djsouthall/hpol-prototype/design/Tri-Slot/Model 8 in/trislot_8in_assembled_feed_full_11-17-2020.stp

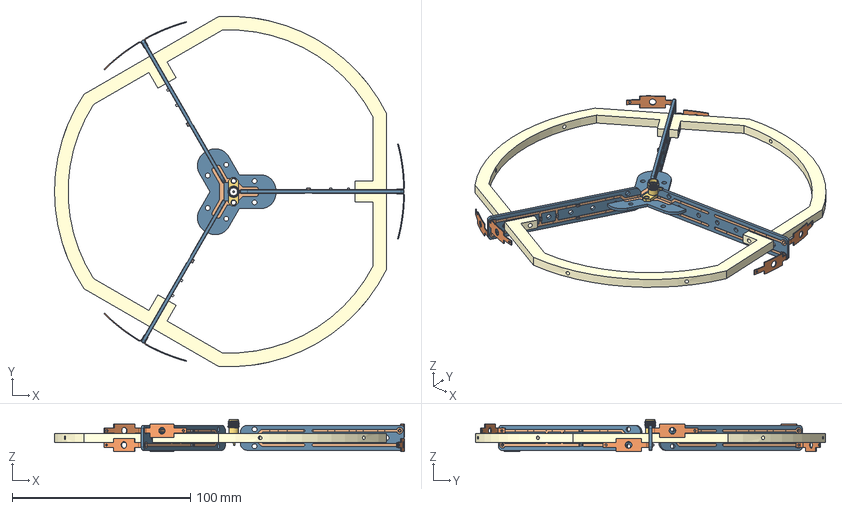
[picture p5: CAD file, 2020-11-19]
design/Tri-Slot/Model 8 in/trislot_8in_assembled_feed_full_11-17-2020.stp
196.1 x 196.2 x 18.1 mm
digikey-mockup-A114140-ND x 6
coppers_drilled#F.Cu x 3
board_solid#F.Cu x 3
insert_8in x 3
board_solid#F.Cu_1
coppers_drilled#F.Cu_1
