djsouthall/hpol-prototype/design/Feed Design/quad-slot-hub_revA/quad-slot-hub_revA/quad-slot-hub-traces.step

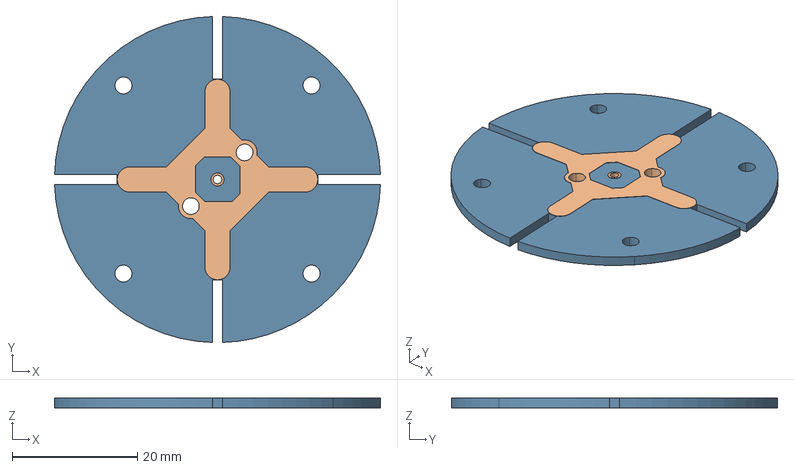
[picture p7: CAD file, 2020-11-04]
design/Feed Design/quad-slot-hub_revA/quad-slot-hub_revA/quad-slot-hub-traces.step
52.0 x 52.0 x 1.60 mm
