djsouthall/hpol-prototype/design/Feed Design/tri-slot-feedlines_revC/tri-slot-feedlines.step

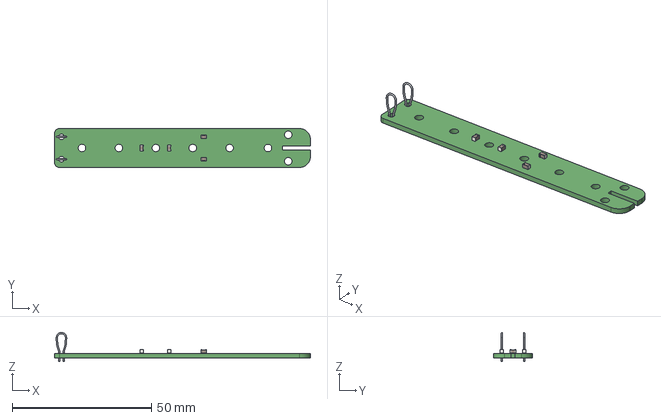
[picture p8: CAD file, 2020-10-09]
design/Feed Design/tri-slot-feedlines_revC/tri-slot-feedlines.step
91.8 x 14.0 x 10.4 mm
