djsouthall/hpol-prototype/design/Feed Design/tri-slot-hub/tri-slot-hub/tri-slot-hub_with_traces_no_sma.step

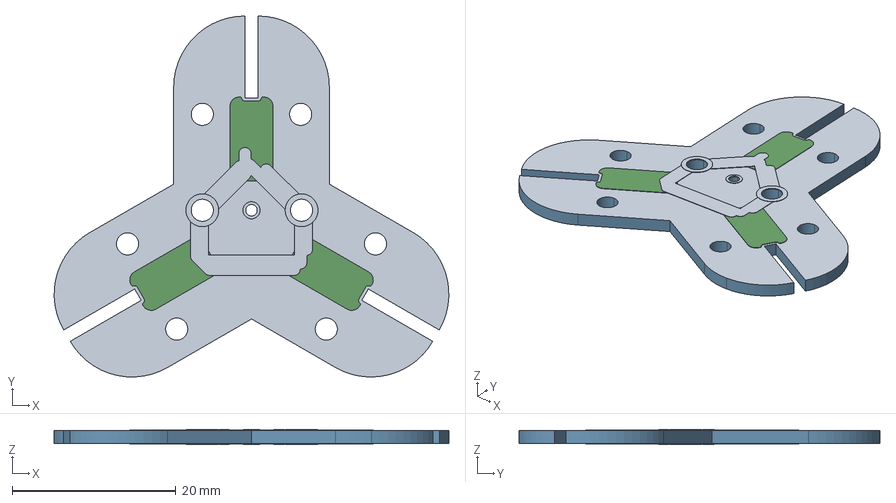
[picture p9: CAD file, 2020-10-19]
design/Feed Design/tri-slot-hub/tri-slot-hub/tri-slot-hub_with_traces_no_sma.step
48.2 x 44.0 x 1.80 mm
