djsouthall/hpol-prototype/design/Feed Design/tri-slot-hub/tri-slot-hub_with_copper.stp

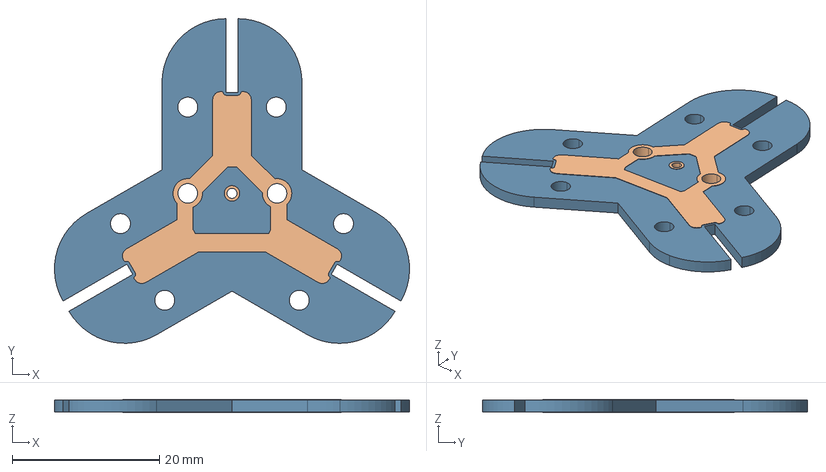
[picture p10: CAD file, 2020-11-19]
design/Feed Design/tri-slot-hub/tri-slot-hub_with_copper.stp
48.2 x 44.0 x 1.70 mm
