djsouthall/hpol-prototype/design/Quad-Slot/Model 8 in/source/hub/raw step/tri-slot-hub.step

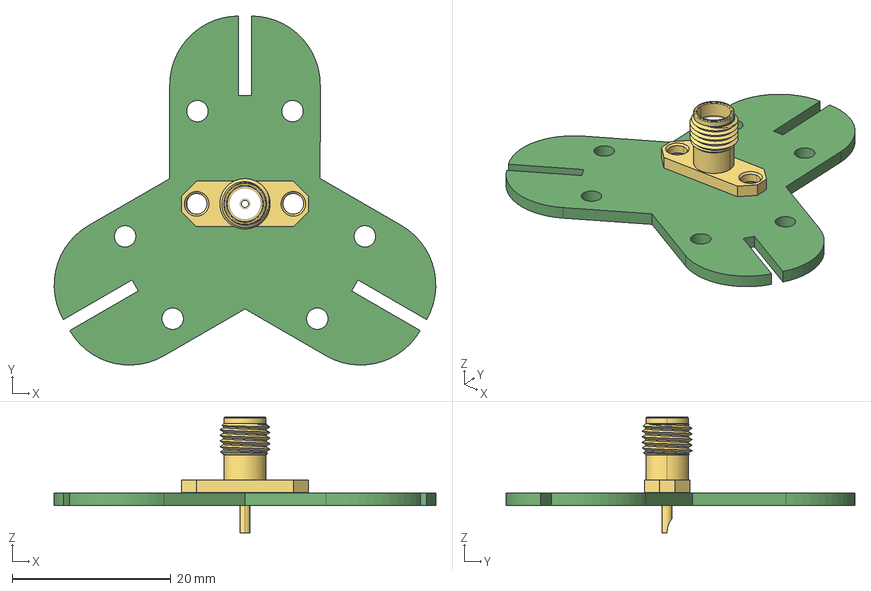
[picture p11: CAD file, 2020-10-09]
design/Quad-Slot/Model 8 in/source/hub/raw step/tri-slot-hub.step
48.2 x 44.0 x 14.6 mm
