djsouthall/hpol-prototype/design/Quad-Slot/Model 8 in/source/my can/quadslot_8in_can_closed_v1.stp

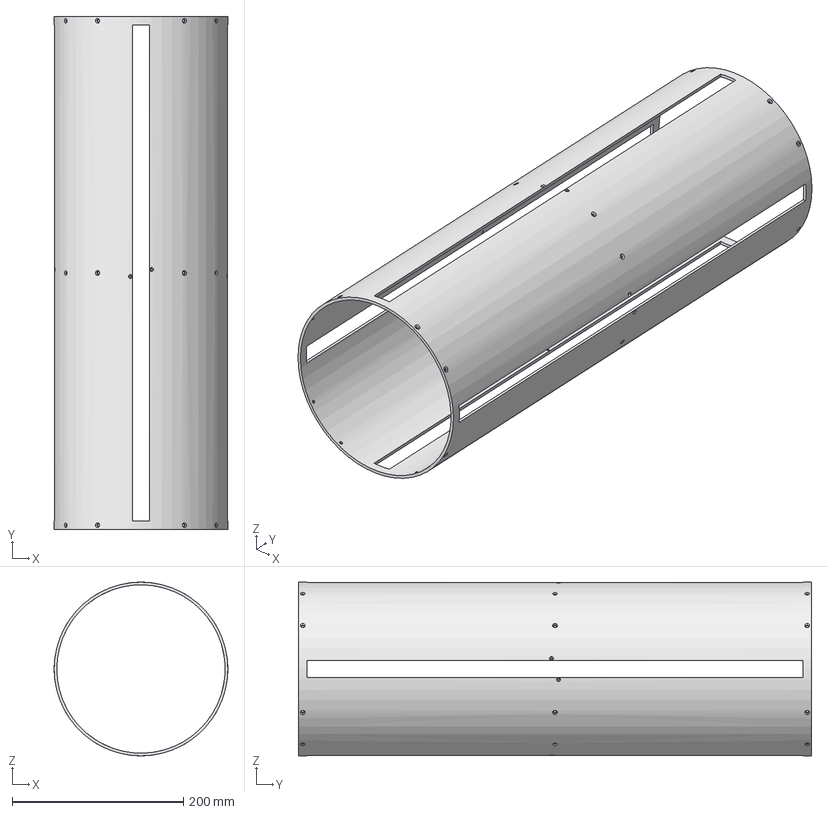
[picture p13: CAD file, 2020-11-13]
design/Quad-Slot/Model 8 in/source/my can/quadslot_8in_can_closed_v1.stp
203.2 x 600.0 x 203.2 mm
