djsouthall/hpol-prototype/design/Quad-Slot/Model 8 in/source/raw step files/aluminum-hpol-can.STEP

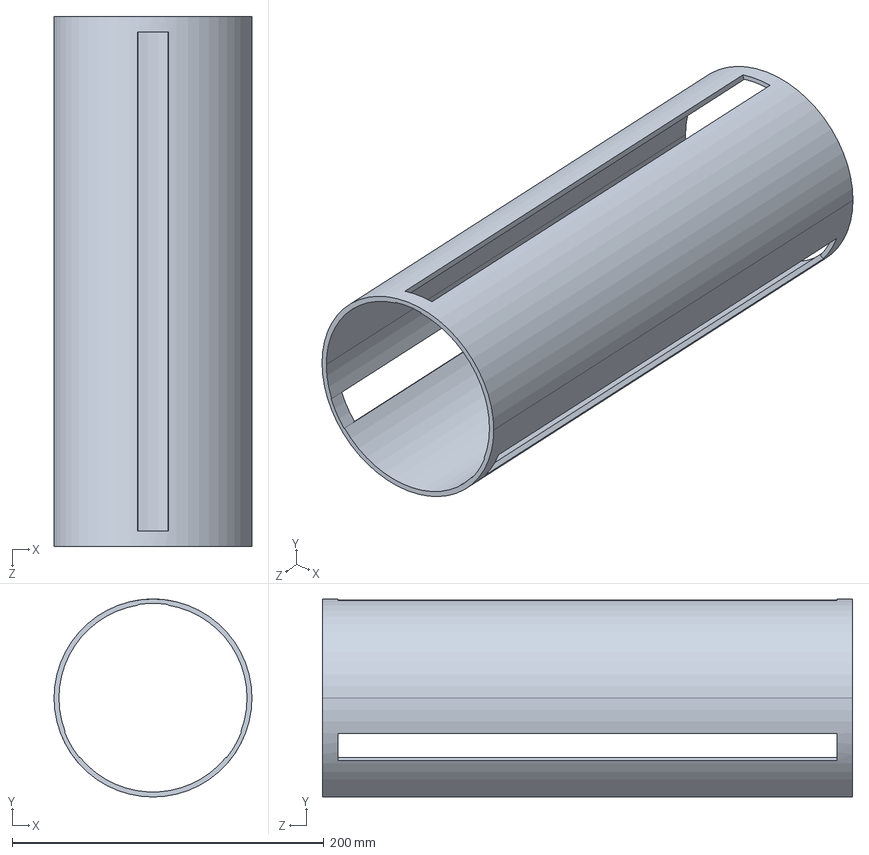
[picture p14: CAD file, 2020-10-09]
design/Quad-Slot/Model 8 in/source/raw step files/aluminum-hpol-can.STEP
127.0 x 127.0 x 340.0 mm
