djsouthall/hpol-prototype/design/Tri-Slot/Model 5 in/source/bryan_insert/raw step/HPol Nylon with Cuts and Reduced Thickness.STEP

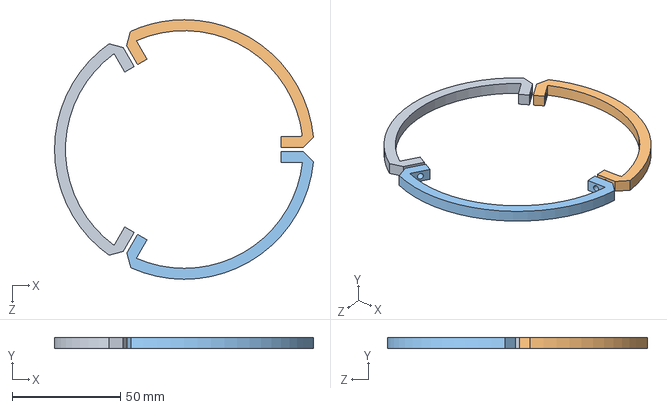
[picture p15: CAD file, 2020-10-09]
design/Tri-Slot/Model 5 in/source/bryan_insert/raw step/HPol Nylon with Cuts and Reduced Thickness.STEP
119.9 x 5.08 x 120.1 mm
