djsouthall/hpol-prototype/design/Tri-Slot/Model 5 in/source/faceplate/raw_step/faceplate.STEP

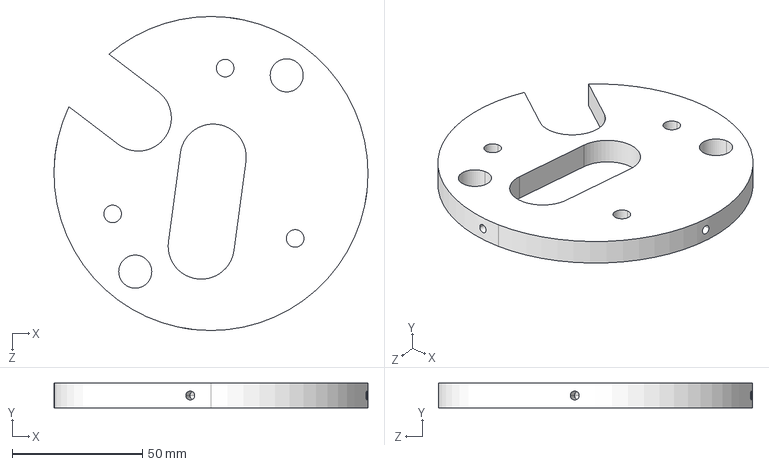
[picture p16: CAD file, 2020-10-09]
design/Tri-Slot/Model 5 in/source/faceplate/raw_step/faceplate.STEP
120.6 x 9.53 x 120.6 mm
