djsouthall/hpol-prototype/design/Tri-Slot/Model 8 in/source/feed_8in_with_copper.step

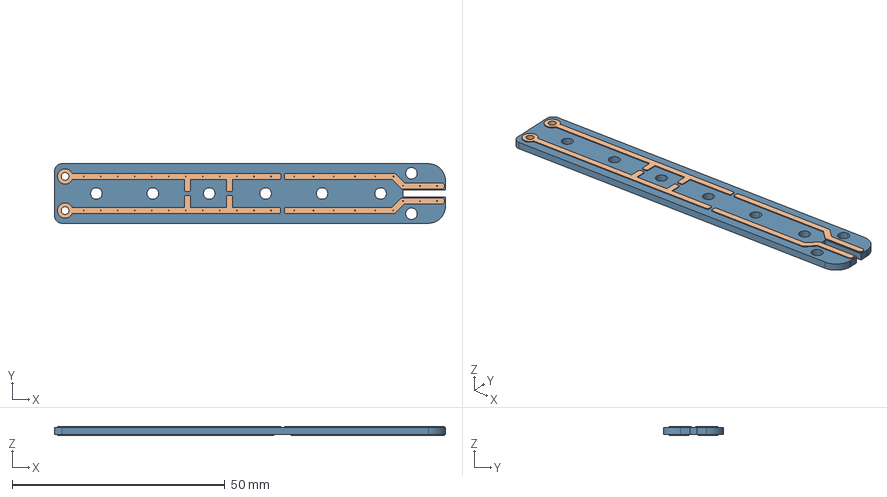
[picture p17: CAD file, 2020-10-09]
design/Tri-Slot/Model 8 in/source/feed_8in_with_copper.step
91.8 x 14.0 x 2.00 mm
