djsouthall/hpol-prototype/design/Tri-Slot/Model 8 in/source/my can/can_open.stp

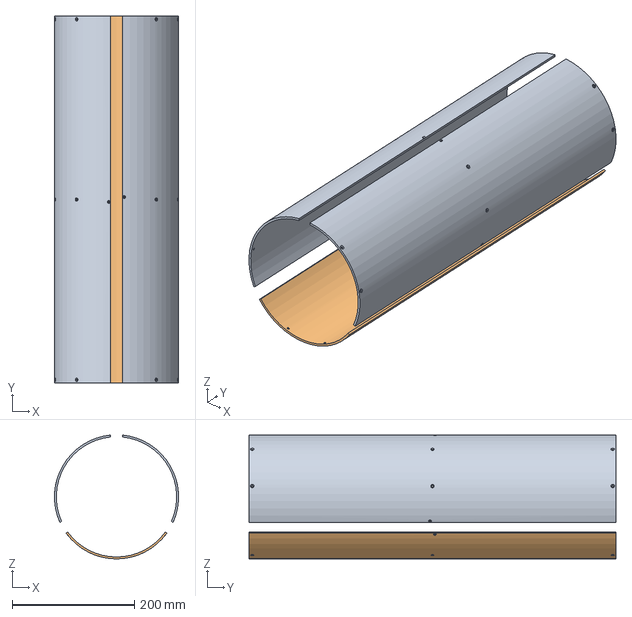
[picture p18: CAD file, 2020-11-03]
design/Tri-Slot/Model 8 in/source/my can/can_open.stp
203.0 x 600.0 x 202.7 mm
