djsouthall/hpol-prototype/design/Tri-Slot/Model 8 in/source/raw step files/tri-slot-feedlines.step

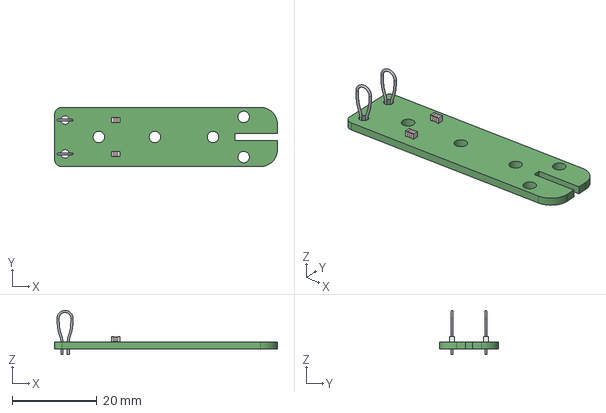
[picture p19: CAD file, 2020-10-09]
design/Tri-Slot/Model 8 in/source/raw step files/tri-slot-feedlines.step
52.8 x 14.0 x 10.4 mm
