djsouthall/hpol-prototype/design/Vpol Parts/End Caps/hub_support.STEP

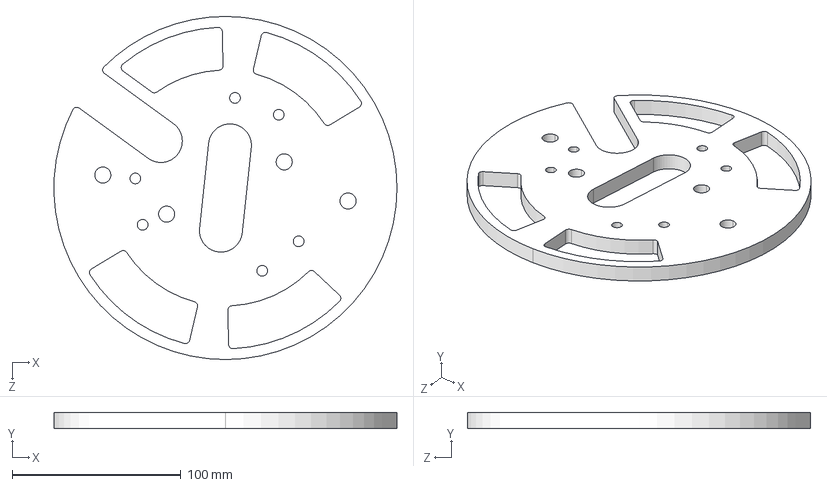
[picture p20: CAD file, 2020-11-19]
design/Vpol Parts/End Caps/hub_support.STEP
203.1 x 9.53 x 203.2 mm
