djsouthall/hpol-prototype/design/Tri-Slot/Model 8 in/source/my can/can_#2_hardware.stp

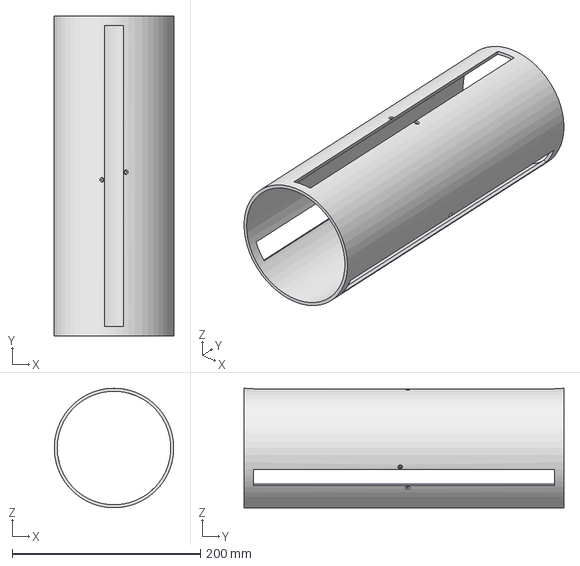
[picture p22: CAD file, 2020-10-09]
design/Tri-Slot/Model 8 in/source/my can/can_#2_hardware.stp
127.0 x 340.0 x 127.0 mm
