djsouthall/hpol-prototype/design/Quad-Slot/Model 8 in/source/front_end_box.STEP

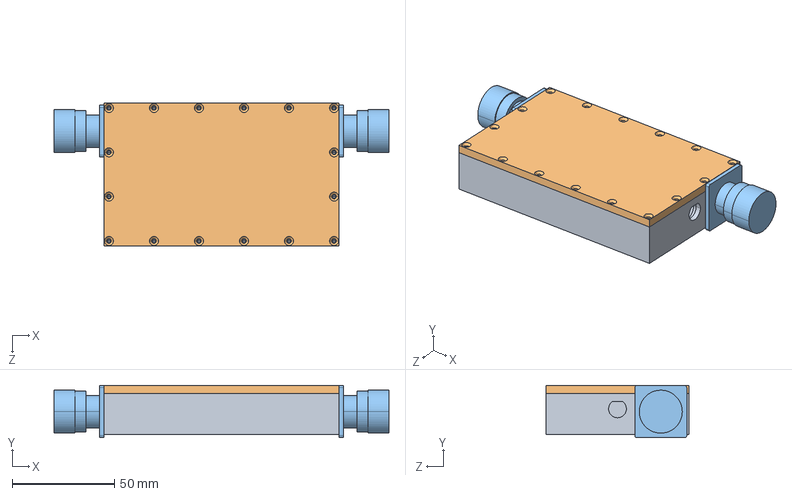
[picture p24: CAD file, 2020-11-19]
design/Quad-Slot/Model 8 in/source/front_end_box.STEP
163.6 x 25.6 x 70.0 mm
inice_bottom
inice_top
fake_sma_with_cable x 2
