djsouthall/hpol-prototype/design/Quad-Slot/Model 8 in/source/quadslot_8in_insert_top_face_v1.dxf

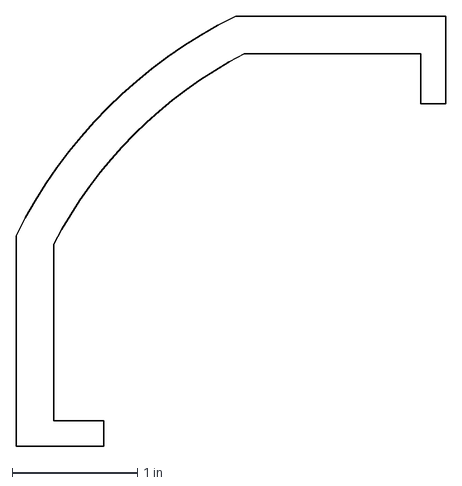
[picture p25: CAD file, 2020-11-13]
design/Quad-Slot/Model 8 in/source/quadslot_8in_insert_top_face_v1.dxf
3.43 x 3.43 in
