djsouthall/hpol-prototype/design/Quad-Slot/Model 8 in/source/2933-6001.STEP

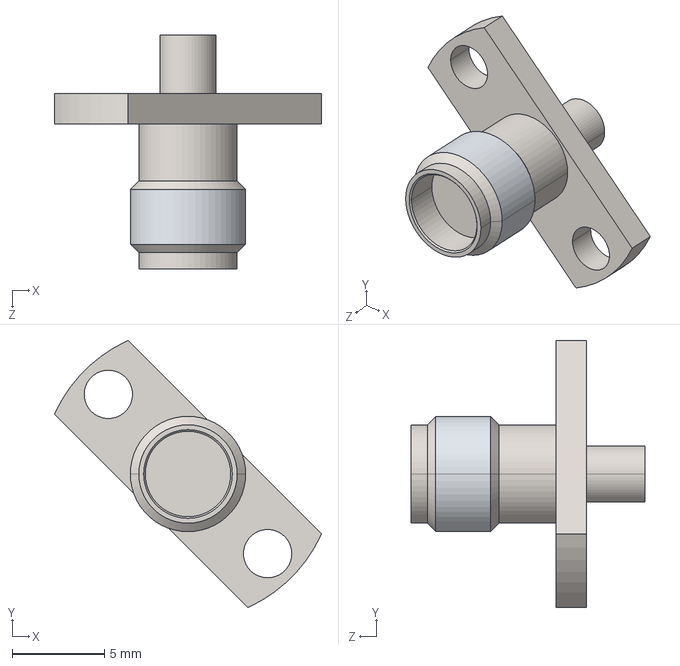
[picture p26: CAD file, 2020-10-19]
design/Quad-Slot/Model 8 in/source/2933-6001.STEP
14.5 x 14.5 x 12.7 mm
