djsouthall/hpol-prototype/(list of files, cad)

Other CAD files:
design/Tri-Slot/Model 8 in/trislot_8in_assembled_feed_no-sma-no-passives_11-17-2020.stp
design/Quad-Slot/Model 8 in/source/my can/can_closed.stp
design/Quad-Slot/Model 8 in/source/quadslot__8in_endcap_drawing_v1.dwg
design/Tri-Slot/Model 8 in/source/my can/can_closed.stp
design/Quad-Slot/Model 8 in/source/my can/can_open.stp
design/Quad-Slot/Model 8 in/source/quadslot__8in_insert_drawing_v2_with_context.dwg
design/Tri-Slot/Model 8 in/source/my can/can_8in_2insert_holes.stp
design/Quad-Slot/Model 8 in/source/my can/can_8in_2insert_holes.stp
design/Quad-Slot/Model 8 in/source/quadslot__8in_insert_drawing_v2.dwg
design/Tri-Slot/Model 8 in/source/my can/can_#1_hardware.stp
design/Quad-Slot/Model 8 in/source/my can/can_all_holes.stp
design/Tri-Slot/Model 8 in/source/my can/can_all_holes.stp
design/Quad-Slot/Model 8 in/source/my can/can_#1_hardware.stp
design/Quad-Slot/Model 8 in/source/quadslot_8in_can_drawing_v1.dwg
design/Feed Design/tri-slot-feedlines_revC/SOLID_1.ipt
design/Feed Design/tri-slot-feedlines_revC/TestPoint_Loop_D3.80mm_Drill2.0mm.iam
design/Model 8 in/source/OldVersions/standin_hub.0003.ipt
design/Model 8 in/source/standin_hub.ipt
design/OldVersions/antenna_comparison.0002.iam
design/Quad-Slot/Model 8 in/92196A077_18-8 STAINLESS STEEL SOCKET HEAD SCR.ipt
design/Quad-Slot/Model 8 in/OldVersions/COMPOUND.0001.ipt
design/Quad-Slot/Model 8 in/OldVersions/assembled-antenna.0037.iam
design/Quad-Slot/Model 8 in/OldVersions/assembled-closed-antenna.0063.iam
design/Quad-Slot/Model 8 in/OldVersions/assembled-feed.0044.iam
design/Quad-Slot/Model 8 in/OldVersions/assembled-feed2.0001.iam
design/Quad-Slot/Model 8 in/OldVersions/assembled-feed_feedline_8in.0010.iam
design/Quad-Slot/Model 8 in/OldVersions/assembled-open-antenna.0040.iam
design/Quad-Slot/Model 8 in/assembled-closed-antenna.iam
design/Quad-Slot/Model 8 in/assembled-feed.iam
design/Quad-Slot/Model 8 in/assembled-feed_feedline_8in.iam
design/Quad-Slot/Model 8 in/assembled-open-antenna.iam
design/Quad-Slot/Model 8 in/quad-assembled-feed-v1.stp
design/Quad-Slot/Model 8 in/source/90001A403_TYPE 18-8 STAINLESS STEEL HEX NUT/90001A403_TYPE 18-8 STAINLESS STEEL HEX NUT.ipt
design/Quad-Slot/Model 8 in/source/90001A403_TYPE 18-8 STAINLESS STEEL HEX NUT/raw step/90001A403_TYPE 18-8 STAINLESS STEEL HEX NUT.STEP
design/Quad-Slot/Model 8 in/source/90001A605_TYPE 18-8 STAINLESS STEEL HEX NUT/90001A605_TYPE 18-8 STAINLESS STEEL HEX NUT.ipt
design/Quad-Slot/Model 8 in/source/90001A605_TYPE 18-8 STAINLESS STEEL HEX NUT/OldVersions/90001A605_TYPE 18-8 STAINLESS STEEL HEX NUT.0001.ipt
design/Quad-Slot/Model 8 in/source/90001A605_TYPE 18-8 STAINLESS STEEL HEX NUT/raw step/90001A605_TYPE 18-8 STAINLESS STEEL HEX NUT.STEP
design/Quad-Slot/Model 8 in/source/90910A440-screw/90910A440_BUTTON HEAD TORX SCREWS.ipt
design/Quad-Slot/Model 8 in/source/90910A440-screw/raw step/90910A440_BUTTON HEAD TORX SCREWS.STEP
design/Quad-Slot/Model 8 in/source/90910A630_LOW-PROFILE BUTTON HEAD TORX MACHINE SCREW/90910A630_LOW-PROFILE BUTTON HEAD TORX MACHINE SCREW.ipt
design/Quad-Slot/Model 8 in/source/90910A630_LOW-PROFILE BUTTON HEAD TORX MACHINE SCREW/raw step/90910A630_LOW-PROFILE BUTTON HEAD TORX MACHINE SCREW.STEP
design/Quad-Slot/Model 8 in/source/90910A630_LOW-PROFILE BUTTON HEAD TORX MACHINE SCREW/raw step/90910A630_LOW-PROFILE BUTTON HEAD TORX MACHINE SCREW.ipt
design/Quad-Slot/Model 8 in/source/90910A632_LOW-PROFILE BUTTON HEAD TORX MACHINE SCREW/90910A632_LOW-PROFILE BUTTON HEAD TORX MACHINE SCREW.ipt
design/Quad-Slot/Model 8 in/source/90910A632_LOW-PROFILE BUTTON HEAD TORX MACHINE SCREW/raw step/90910A632_LOW-PROFILE BUTTON HEAD TORX MACHINE SCREW.STEP
design/Quad-Slot/Model 8 in/source/90910A634_LOW-PROFILE BUTTON HEAD TORX MACHINE SCREW/90910A634_LOW-PROFILE BUTTON HEAD TORX MACHINE SCREW.ipt
design/Quad-Slot/Model 8 in/source/90910A634_LOW-PROFILE BUTTON HEAD TORX MACHINE SCREW/raw step/90910A634_LOW-PROFILE BUTTON HEAD TORX MACHINE SCREW.STEP
design/Quad-Slot/Model 8 in/source/91841A003_TYPE 18-8 STAINLESS STEEL HEX NUT/91841A003_TYPE 18-8 STAINLESS STEEL HEX NUT.ipt
design/Quad-Slot/Model 8 in/source/91841A003_TYPE 18-8 STAINLESS STEEL HEX NUT/raw step/91841A003_TYPE 18-8 STAINLESS STEEL HEX NUT.STEP
design/Quad-Slot/Model 8 in/source/91841A125_TYPE 18-8 STAINLESS STEEL HEX NUT/91841A125_TYPE 18-8 STAINLESS STEEL HEX NUT.ipt
design/Quad-Slot/Model 8 in/source/91841A125_TYPE 18-8 STAINLESS STEEL HEX NUT/new step/91841A125_TYPE 18-8 STAINLESS STEEL HEX NUT.STEP
design/Quad-Slot/Model 8 in/source/92141A003_TYPE 18-8 STAINLESS STEEL FLAT WASHER/92141A003_TYPE 18-8 STAINLESS STEEL FLAT WASHER.ipt
design/Quad-Slot/Model 8 in/source/92141A003_TYPE 18-8 STAINLESS STEEL FLAT WASHER/OldVersions/92141A003_TYPE 18-8 STAINLESS STEEL FLAT WASHER.0001.ipt
design/Quad-Slot/Model 8 in/source/92141A003_TYPE 18-8 STAINLESS STEEL FLAT WASHER/raw step/92141A003_TYPE 18-8 STAINLESS STEEL FLAT WASHER.STEP
design/Quad-Slot/Model 8 in/source/92141A207_TYPE 18-8 STAINLESS STEEL FLAT WASHER/92141A207_TYPE 18-8 STAINLESS STEEL FLAT WASHER.ipt
design/Quad-Slot/Model 8 in/source/92141A207_TYPE 18-8 STAINLESS STEEL FLAT WASHER/raw step/92141A207_TYPE 18-8 STAINLESS STEEL FLAT WASHER.STEP
design/Quad-Slot/Model 8 in/source/92141A207_TYPE 18-8 STAINLESS STEEL FLAT WASHER/raw step/OldVersions/92141A207_TYPE 18-8 STAINLESS STEEL FLAT WASHER.0001.ipt
design/Quad-Slot/Model 8 in/source/92196A077_18-8 STAINLESS STEEL SOCKET HEAD SCREW/92196A077_18-8 STAINLESS STEEL SOCKET HEAD SCREW.STEP
design/Quad-Slot/Model 8 in/source/92210A018_18-8 STAINLESS STEEL FLAT-HEAD SCKT CAP SCREW/92210A018_18-8 STAINLESS STEEL FLAT-HEAD SCKT CAP SCREW.ipt
design/Quad-Slot/Model 8 in/source/92210A018_18-8 STAINLESS STEEL FLAT-HEAD SCKT CAP SCREW/OldVersions/92210A018_18-8 STAINLESS STEEL FLAT-HEAD SCKT CAP SCREW.0002.ipt
design/Quad-Slot/Model 8 in/source/92210A018_18-8 STAINLESS STEEL FLAT-HEAD SCKT CAP SCREW/raw step/92210A018_18-8 STAINLESS STEEL FLAT-HEAD SCKT CAP SCREW.STEP
design/Quad-Slot/Model 8 in/source/92210A019_18-8 STAINLESS STEEL FLAT-HEAD SCKT CAP SCREW/92210A019_18-8 STAINLESS STEEL FLAT-HEAD SCKT CAP SCREW.ipt
design/Quad-Slot/Model 8 in/source/92210A019_18-8 STAINLESS STEEL FLAT-HEAD SCKT CAP SCREW/OldVersions/92210A019_18-8 STAINLESS STEEL FLAT-HEAD SCKT CAP SCREW.0001.ipt
design/Quad-Slot/Model 8 in/source/92210A019_18-8 STAINLESS STEEL FLAT-HEAD SCKT CAP SCREW/raw step/92210A019_18-8 STAINLESS STEEL FLAT-HEAD SCKT CAP SCREW.STEP
design/Quad-Slot/Model 8 in/source/92210A081_18-8 SS HEX DRIVE FLAT HEAD SCREW/92210A081_18-8 SS HEX DRIVE FLAT HEAD SCREW.ipt
design/Quad-Slot/Model 8 in/source/92210A081_18-8 SS HEX DRIVE FLAT HEAD SCREW/raw step/92210A081_18-8 SS HEX DRIVE FLAT HEAD SCREW.STEP
design/Quad-Slot/Model 8 in/source/96877A118_18-8 SS 82 DEG FLAT HEAD PHIL MACHINE SCREW/96877A118_18-8 SS 82 DEG FLAT HEAD PHIL MACHINE SCREW.ipt
design/Quad-Slot/Model 8 in/source/96877A118_18-8 SS 82 DEG FLAT HEAD PHIL MACHINE SCREW/raw step/96877A118_18-8 SS 82 DEG FLAT HEAD PHIL MACHINE SCREW.STEP
design/Quad-Slot/Model 8 in/source/99362A200_TAPPING INSERTS FOR PLASTICS/99362A200_TAPPING INSERTS FOR PLASTICS.ipt
design/Quad-Slot/Model 8 in/source/99362A200_TAPPING INSERTS FOR PLASTICS/raw/99362A200_TAPPING INSERTS FOR PLASTICS.STEP
design/Quad-Slot/Model 8 in/source/End Cap.ipt
design/Quad-Slot/Model 8 in/source/OldVersions/End Cap.0061.ipt
design/Quad-Slot/Model 8 in/source/OldVersions/digikey-mockup-A114140-ND.0029.ipt
design/Quad-Slot/Model 8 in/source/OldVersions/insert_8in.0020.ipt
design/Quad-Slot/Model 8 in/source/OldVersions/my_faceplate.0004.ipt
design/Quad-Slot/Model 8 in/source/OldVersions/new_insert.0013.ipt
design/Quad-Slot/Model 8 in/source/OldVersions/quadslot_8in_can_drawing_v1.0004.dwg
design/Quad-Slot/Model 8 in/source/OldVersions/quadslot__8in_endcap_drawing_v1.0010.dwg
design/Quad-Slot/Model 8 in/source/OldVersions/quadslot__8in_insert_drawing_v1.0008.dwg
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
