djsouthall/hpol-prototype/data/hpol_al_tube_testing_sep2020/s11/hpol_ernieemu_100nh_2p7pf_LOGMAG.csv

! FILETYPE CSV
! VERSION 1.0 | 1
! TIMESTAMP Friday | 11 September 2020 03:17:18
! NAME Agilent Technologies
! MODEL N9923A
! SERIAL MY52412229
! FIRMWARE_VERSION A.07.32
! GPS_LATITUDE
! GPS_LONGITUDE
! GPS_TIMESTAMP 0001-01-01 00:00:00Z
! GPS_SECS_SINCE_LAST_READ 0
! CHECKSUM 0181437629
! CORRECTION1 ON U
! DATA Freq | S11
! FREQ UNIT Hz
! DATA UNIT dB
BEGIN
2000000 | -0.0503085302110614
3247500 | -0.0502693878862208
4495000 | -0.0558177333302138
5742500 | -0.0720455049161942
6990000 | -0.0877329702639762
8237500 | -0.0949461024743461
9485000 | -0.0937054668446422
10732500 | -0.090836961658721
11980000 | -0.0965173236783473
13227500 | -0.105593016692517
14475000 | -0.124709681584494
15722500 | -0.134502215697922
16970000 | -0.131118824248321
18217500 | -0.125181549103601
19465000 | -0.126701744330034
20712500 | -0.139361509446922
21960000 | -0.154004162462201
23207500 | -0.162301106793484
24455000 | -0.158739956499021
25702500 | -0.153913687595007
26950000 | -0.157315646144101
28197500 | -0.179412468252848
29445000 | -0.188325093156634
30692500 | -0.195911279118745
31940000 | -0.189821808178646
33187500 | -0.184268556809222
34435000 | -0.182890925940987
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
