djsouthall/hpol-prototype/data/hpol_al_tube_testing_sep2020/s11/hpol_ernieemu_100nh_2p7pf_PHASE.csv

! FILETYPE CSV
! VERSION 1.0 | 1
! TIMESTAMP Friday | 11 September 2020 03:17:45
! NAME Agilent Technologies
! MODEL N9923A
! SERIAL MY52412229
! FIRMWARE_VERSION A.07.32
! GPS_LATITUDE
! GPS_LONGITUDE
! GPS_TIMESTAMP 0001-01-01 00:00:00Z
! GPS_SECS_SINCE_LAST_READ 0
! CHECKSUM 1783225229
! CORRECTION1 ON U
! DATA Freq | S11
! FREQ UNIT Hz
! DATA UNIT Degrees
BEGIN
2000000 | 178.653981651671
3247500 | 177.923297335316
4495000 | 177.21445043058
5742500 | 176.494028604439
6990000 | 175.749189713599
8237500 | 174.988517034322
9485000 | 174.262280504222
10732500 | 173.571626096748
11980000 | 172.926905216975
13227500 | 172.230962686618
14475000 | 171.495209503116
15722500 | 170.748906723498
16970000 | 170.026974549218
18217500 | 169.355231791234
19465000 | 168.674122558394
20712500 | 168.00092225663
21960000 | 167.270610228085
23207500 | 166.523344126363
24455000 | 165.768068114879
25702500 | 165.076639725549
26950000 | 164.396024178031
28197500 | 163.759140229574
29445000 | 163.024610738587
30692500 | 162.281597307846
31940000 | 161.526149131494
33187500 | 160.84419587273
34435000 | 160.151523145895
35682500 | 159.454545276565
36930000 | 158.692735962718
38177500 | 157.930775314046
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
