djsouthall/hpol-prototype/data/hpol_al_tube_testing_sep2020/s11/hpol_ernieemu_22nh_2p7pF_LOGMAG.csv

! FILETYPE CSV
! VERSION 1.0 | 1
! TIMESTAMP Tuesday | 29 September 2020 03:41:09
! NAME Agilent Technologies
! MODEL N9923A
! SERIAL MY52412229
! FIRMWARE_VERSION A.07.32
! GPS_LATITUDE
! GPS_LONGITUDE
! GPS_TIMESTAMP 0001-01-01 00:00:00Z
! GPS_SECS_SINCE_LAST_READ 0
! CHECKSUM 1680324423
! CORRECTION1 ON U
! DATA Freq | S11
! FREQ UNIT Hz
! DATA UNIT dB
BEGIN
2000000 | -0.00561830944414967
3872500 | -0.0180779658912381
5745000 | -0.0186978299560727
7617500 | -0.0201100676719355
9490000 | -0.0253952298342751
11362500 | -0.0292339184209452
13235000 | -0.026628549991537
15107500 | -0.0280928617618431
16980000 | -0.0293405993049359
18852500 | -0.0311168891898071
20725000 | -0.0302447422845374
22597500 | -0.0275968798973183
24470000 | -0.0327777683237042
26342500 | -0.0355193385226714
28215000 | -0.0319068763895323
30087500 | -0.0327057518997466
31960000 | -0.0374741085850054
33832500 | -0.0400069092290901
35705000 | -0.0404648421401449
37577500 | -0.0337216238410423
39450000 | -0.0415584417056998
41322500 | -0.0419569267285135
43195000 | -0.0419995827417472
45067500 | -0.0386594259226934
46940000 | -0.0399873171901005
48812500 | -0.0445743995213478
50685000 | -0.0433537955810497
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
