djsouthall/hpol-prototype/data/hpol_al_tube_testing_sep2020/s11/hpol_ernieemu_22nh_2p7pF_PHASE.csv

! FILETYPE CSV
! VERSION 1.0 | 1
! TIMESTAMP Tuesday | 29 September 2020 03:41:42
! NAME Agilent Technologies
! MODEL N9923A
! SERIAL MY52412229
! FIRMWARE_VERSION A.07.32
! GPS_LATITUDE
! GPS_LONGITUDE
! GPS_TIMESTAMP 0001-01-01 00:00:00Z
! GPS_SECS_SINCE_LAST_READ 0
! CHECKSUM 0610545866
! CORRECTION1 ON U
! DATA Freq | S11
! FREQ UNIT Hz
! DATA UNIT Degrees
BEGIN
2000000 | 179.626875614549
3872500 | 179.21452691657
5745000 | 178.80306898875
7617500 | 178.517829501344
9490000 | 178.263497930671
11362500 | 177.889685544102
13235000 | 177.494873043952
15107500 | 177.209779926913
16980000 | 176.943247894469
18852500 | 176.564607454533
20725000 | 176.159901216548
22597500 | 175.849792570653
24470000 | 175.575492618403
26342500 | 175.224749943323
28215000 | 174.805381959792
30087500 | 174.476105171022
31960000 | 174.195085104511
33832500 | 173.834815818014
35705000 | 173.410768838543
37577500 | 173.118983653655
39450000 | 172.850652502512
41322500 | 172.503378498348
43195000 | 172.09425405815
45067500 | 171.76867214863
46940000 | 171.54174502115
48812500 | 171.17520929478
50685000 | 170.745757698057
52557500 | 170.42512635206
54430000 | 170.190739382711
56302500 | 169.835219170555
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
