djsouthall/hpol-prototype/data/hpol_al_tube_testing_sep2020/s11/hpol_ernieemu_NOSHUNT_2p7pf_LOGMAG.csv

! FILETYPE CSV
! VERSION 1.0 | 1
! TIMESTAMP Friday | 11 September 2020 03:46:13
! NAME Agilent Technologies
! MODEL N9923A
! SERIAL MY52412229
! FIRMWARE_VERSION A.07.32
! GPS_LATITUDE
! GPS_LONGITUDE
! GPS_TIMESTAMP 0001-01-01 00:00:00Z
! GPS_SECS_SINCE_LAST_READ 0
! CHECKSUM 1762540154
! CORRECTION1 ON U
! DATA Freq | S11
! FREQ UNIT Hz
! DATA UNIT dB
BEGIN
2000000 | -0.00362645845585015
3872500 | -0.00778344149930804
5745000 | -0.00620458920771222
7617500 | -0.00551768101463744
9490000 | -0.0080035640923972
11362500 | -0.0132290547635721
13235000 | -0.0153866694001706
15107500 | -0.0736717853968342
16980000 | -0.124751151138426
18852500 | -0.0207655011407515
20725000 | -0.021794891611287
22597500 | -0.0277977125717659
24470000 | -0.0298224985325749
26342500 | -0.0604635779695736
28215000 | -0.497245080680764
30087500 | -0.363713290167115
31960000 | -0.164284945946851
33832500 | -0.185270102447499
35705000 | -0.131153647529332
37577500 | -0.119245246759605
39450000 | -0.156561676725659
41322500 | -0.534452405481218
43195000 | -0.339521299602014
45067500 | -0.0755976488465598
46940000 | -0.0697655468858354
48812500 | -0.112967177319526
50685000 | -0.179850112723151
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
