djsouthall/hpol-prototype/data/hpol_al_tube_testing_sep2020/s11/hpol_ernieemu_NOSHUNT_2p7pf_PHASE.csv

! FILETYPE CSV
! VERSION 1.0 | 1
! TIMESTAMP Friday | 11 September 2020 03:46:35
! NAME Agilent Technologies
! MODEL N9923A
! SERIAL MY52412229
! FIRMWARE_VERSION A.07.32
! GPS_LATITUDE
! GPS_LONGITUDE
! GPS_TIMESTAMP 0001-01-01 00:00:00Z
! GPS_SECS_SINCE_LAST_READ 0
! CHECKSUM 2006022341
! CORRECTION1 ON U
! DATA Freq | S11
! FREQ UNIT Hz
! DATA UNIT Degrees
BEGIN
2000000 | -1.03049737025287
3872500 | -1.93217726127105
5745000 | -2.90931332089694
7617500 | -3.84198767600028
9490000 | -4.78538887753015
11362500 | -5.79568484526215
13235000 | -6.83262165914027
15107500 | -8.30770710574872
16980000 | -7.77889995402948
18852500 | -9.18759242672272
20725000 | -10.3744093340567
22597500 | -11.4505126598937
24470000 | -12.6920412565587
26342500 | -14.4119735503669
28215000 | -17.4610880979234
30087500 | -11.8779808842817
31960000 | -14.4134676215306
33832500 | -15.5153117686469
35705000 | -16.5929362404774
37577500 | -17.8683040581829
39450000 | -19.3033736270872
41322500 | -21.9428492078533
43195000 | -17.4253714280063
45067500 | -19.9343808496582
46940000 | -21.6623818055144
48812500 | -23.1744046238109
50685000 | -24.4433965550901
52557500 | -25.7212058983106
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
