djsouthall/hpol-prototype/design/Quad-Slot/Model 8 in/source/quadslot__8in_insert_drawing_v2_with_context.pdf

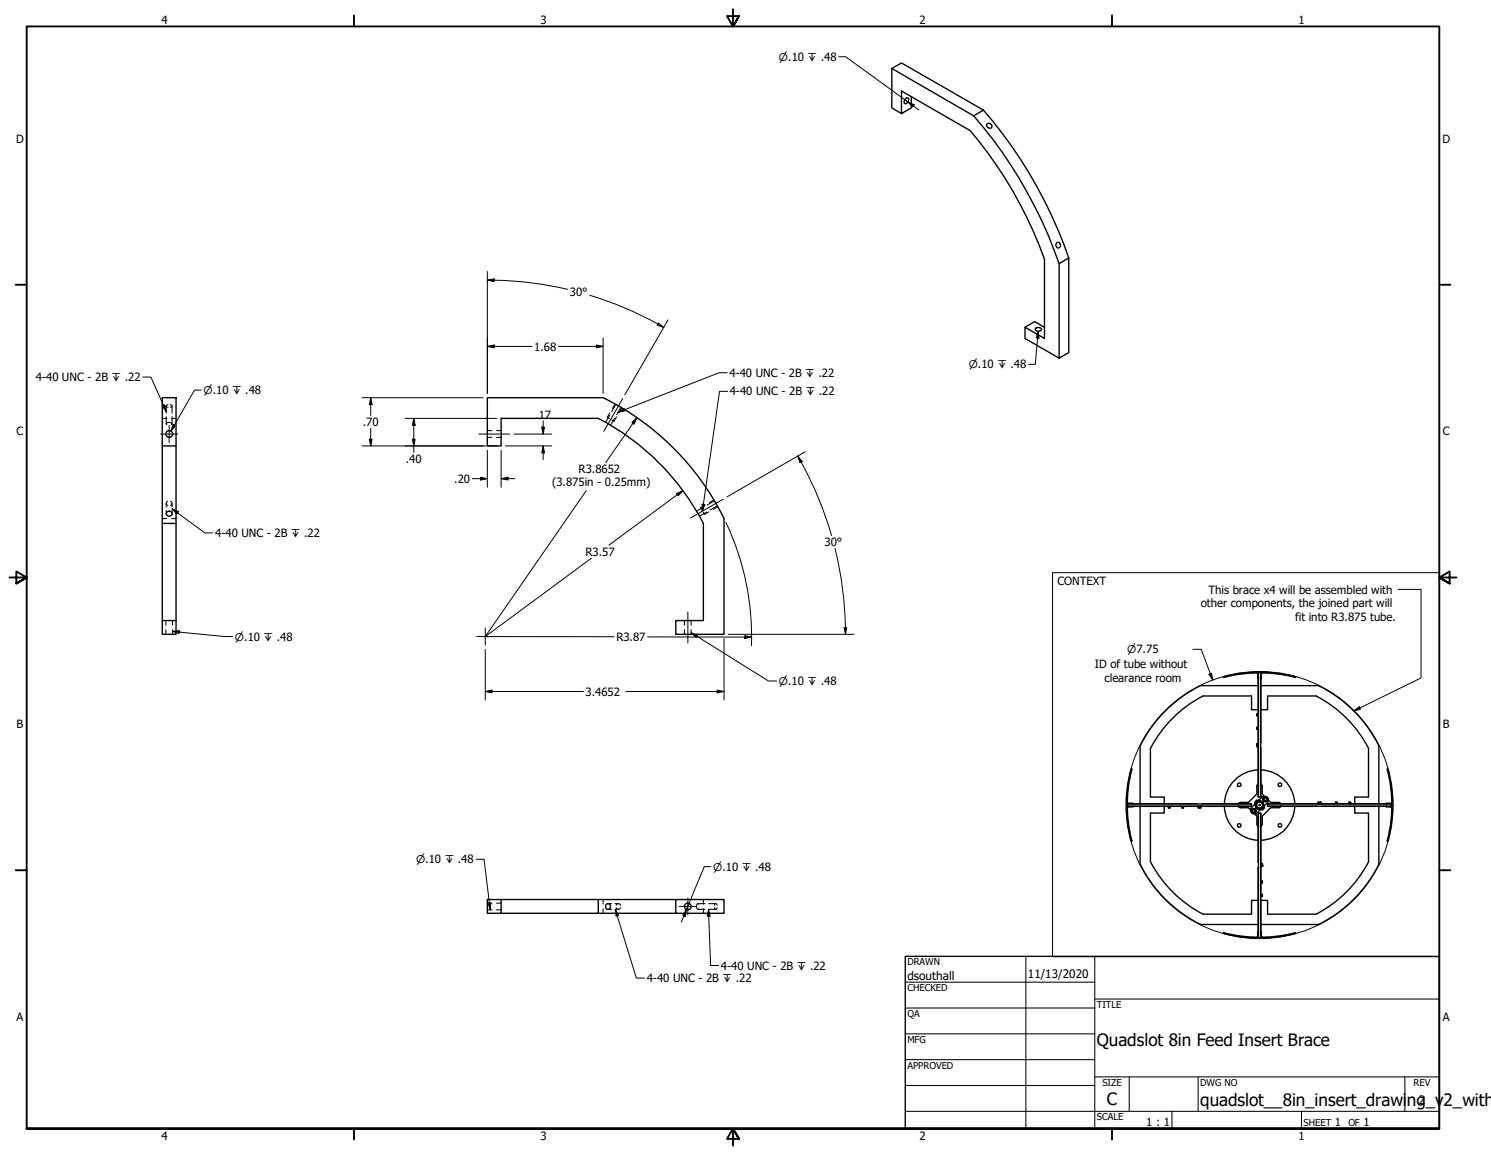
[picture p28: page 1]

This brace x4 will be assembled with
other components, the joined part will

fit into R3.875 tube.

ID of tube without
clearance room

DRAWN dsouthall | 11/13/2020

CHECKED

MFG

Quadslot 8in Feed Insert Brace

APPROVED

SIZE C | DWG NO | REV 2

SCALE 1 : 1 | | SHEET 1 OF 1
