djsouthall/hpol-prototype/design/Quad-Slot/Model 8 in/source/quadslot_8in_can_drawing_v1.pdf

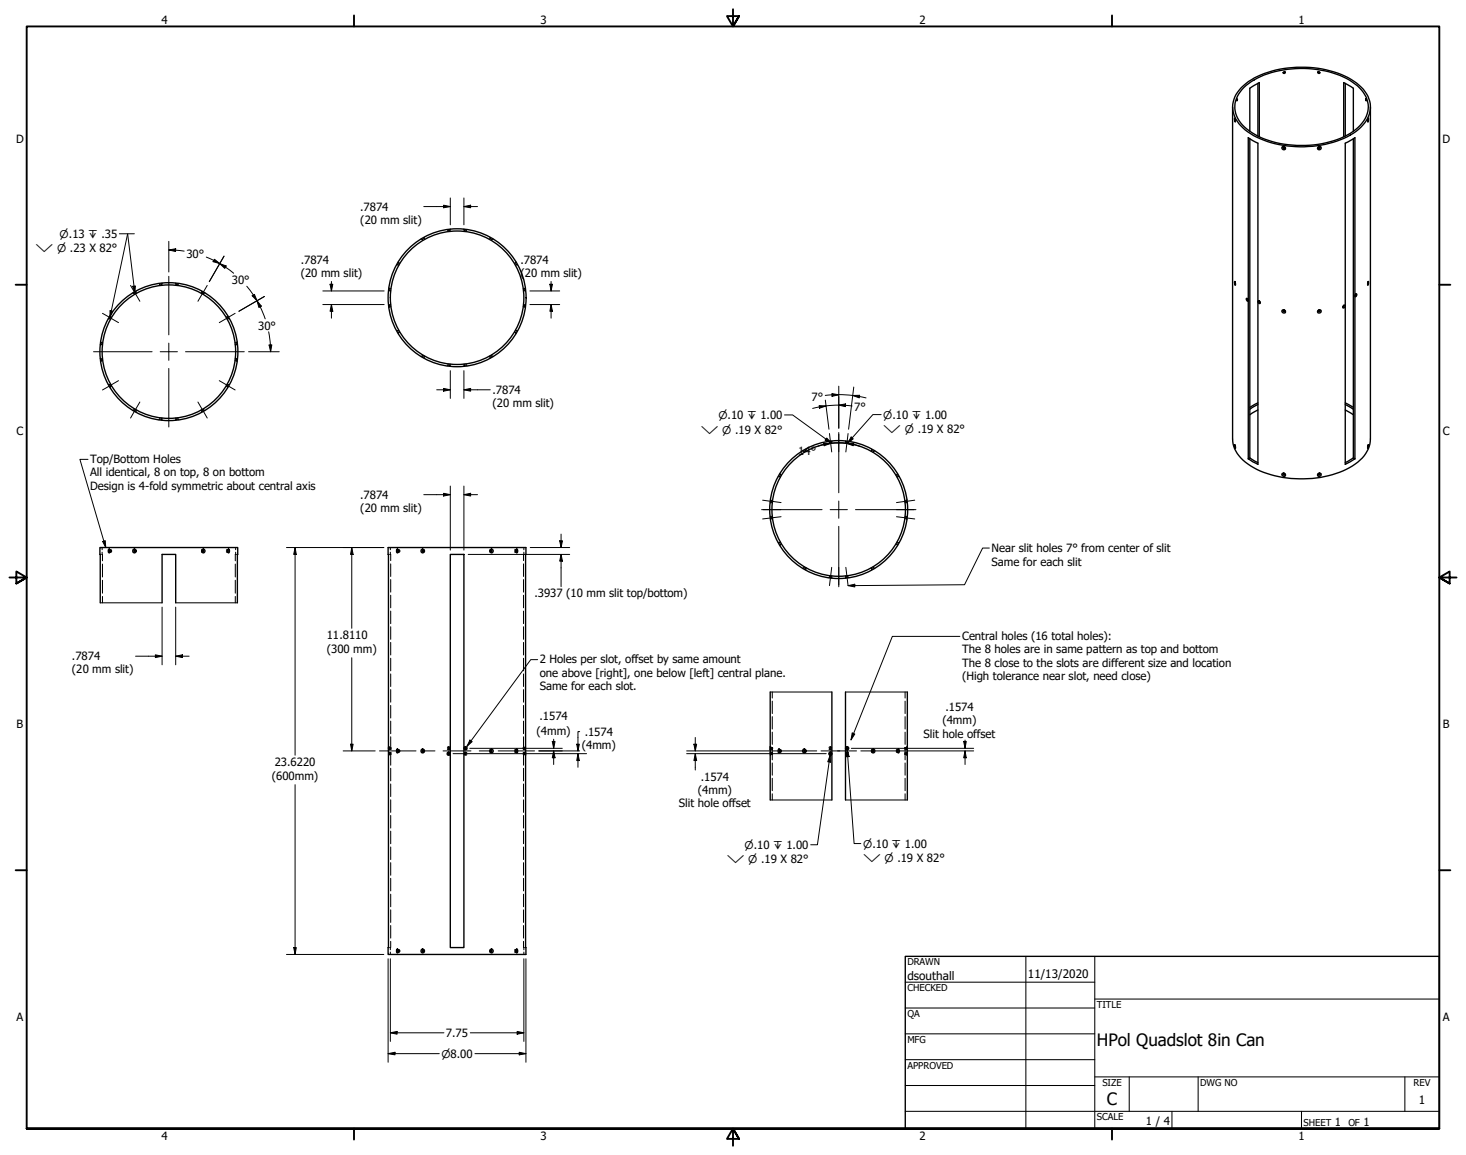
[picture p29: page 1]
(20 mm slit); Slit hole offset

Top/Bottom Holes
All identical, 8 on top, 8 on bottom
Design is 4-fold symmetric about central axis

Near slit holes 7° from center of slit
Same for each slit

.3937 (10 mm slit top/bottom)

Central holes (16 total holes):
The 8 holes are in same pattern as top and bottom
The 8 close to the slots are different size and location
(High tolerance near slot, need close)

2 Holes per slot, offset by same amount
one above [right], one below [left] central plane.
Same for each slot.

DRAWN dsouthall | 11/13/2020

CHECKED

MFG

HPol Quadslot 8in Can

APPROVED

SIZE C | DWG NO | REV 1

SCALE 1 / 4 | | SHEET 1 OF 1
