djsouthall/hpol-prototype/design/Vpol Parts/End Caps/hub_support.PDF

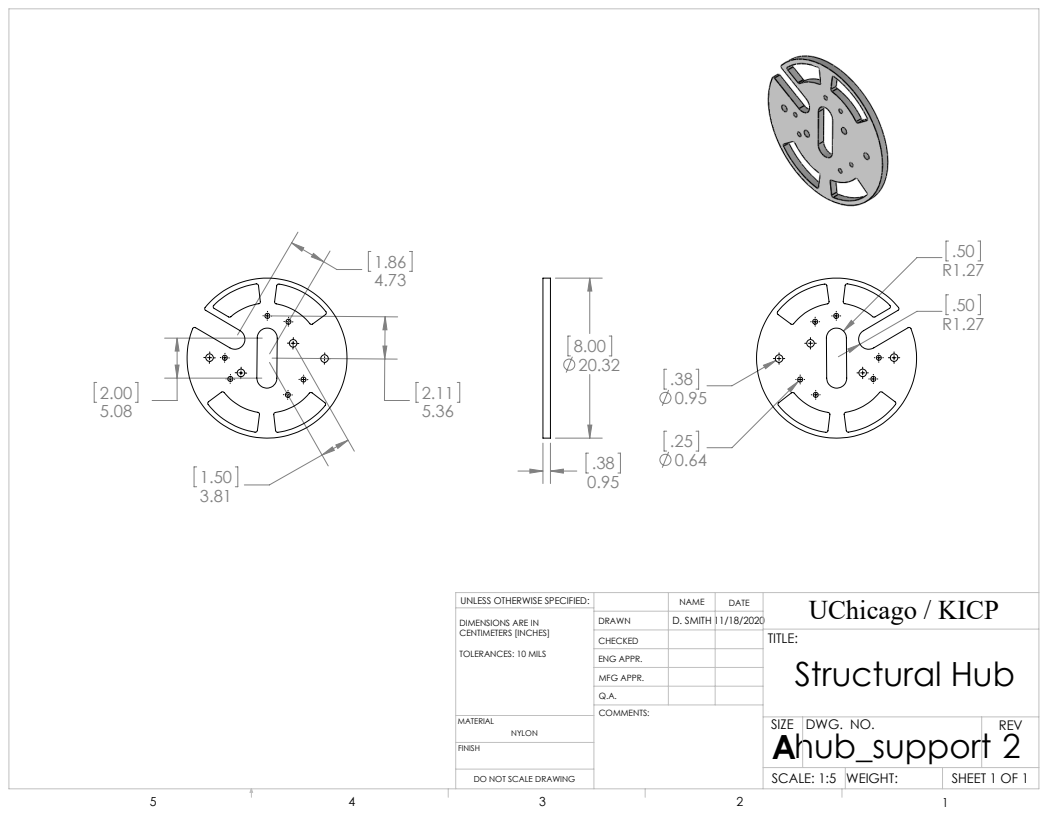
[picture p30: page 1]
Structural Hub; SHEET 1 OF 1; D. SMITH 11/18/2020; SCALE: 1:5 WEIGHT:; DWG. NO.; REV; UChicago / KICP NAME; DATE; MFG APPR.; ENG APPR.

UNLESS OTHERWISE SPECIFIED:

DIMENSIONS ARE IN
CENTIMETERS [INCHES]
TOLERANCES: 10 MILS

DO NOT SCALE DRAWING
