djsouthall/hpol-prototype/design/Feed Design/tri-slot-hub_revB/tri-slot-hub_revB/tri-slot-hub.kicad_pcb

## KiCad design design/Feed Design/tri-slot-hub_revB/tri-slot-hub_revB/tri-slot-hub.kicad_pcb (2020-10-16, an earlier design)

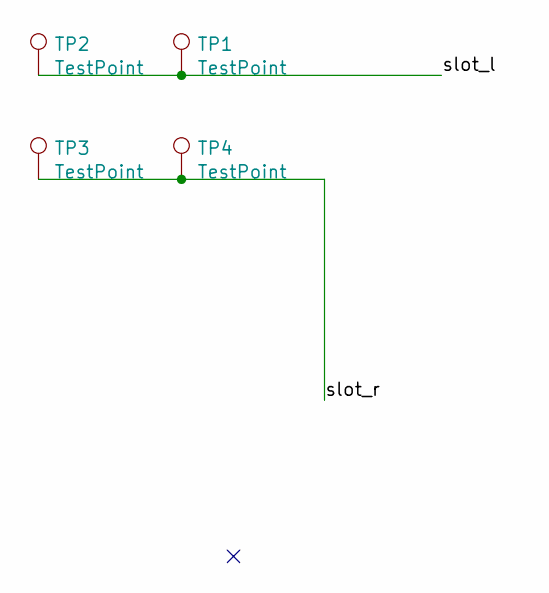
[picture p31: schematic tri-slot-hub.sch]

Parts:
TP1, TP2, TP3, TP4: TestPoint; TestPoint_Pad_1.0x1.0mm

Connections:
/slot_l: TP1.1, TP2.1
/slot_r: TP3.1, TP4.1

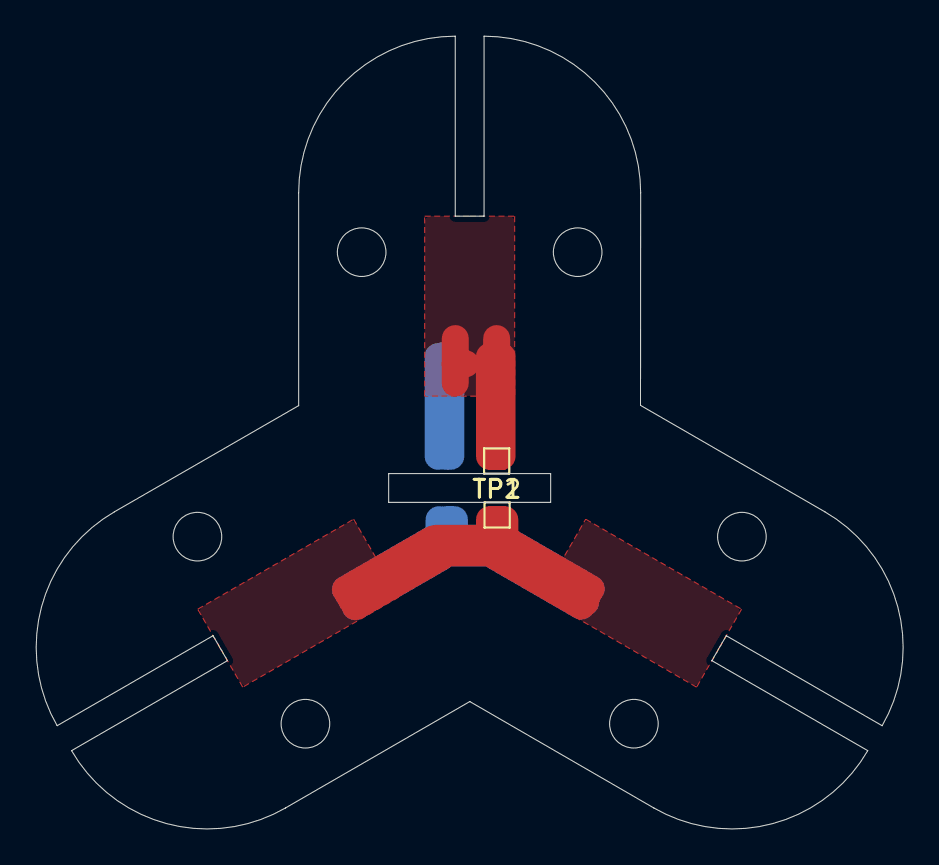
[picture p32: board tri-slot-hub.kicad_pcb from above]

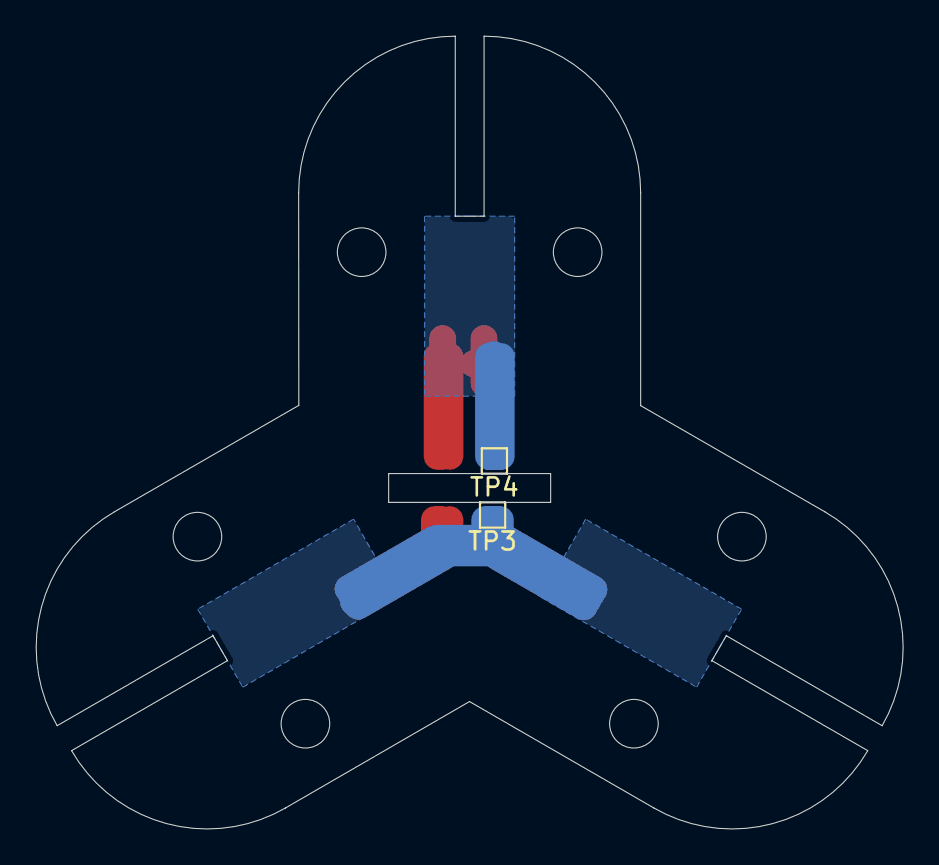
[picture p33: board tri-slot-hub.kicad_pcb from below]

Board: 2 copper layers, 48.2 x 44.0 mm, 4 parts (2 on the bottom side), 2 nets.
