djsouthall/hpol-prototype/design/Feed Design/tri-slot-hub_xformPlug/tri-slot-hub_xformPlug/xform-plug.kicad_pcb

## KiCad design design/Feed Design/tri-slot-hub_xformPlug/tri-slot-hub_xformPlug/xform-plug.kicad_pcb (2020-10-16)

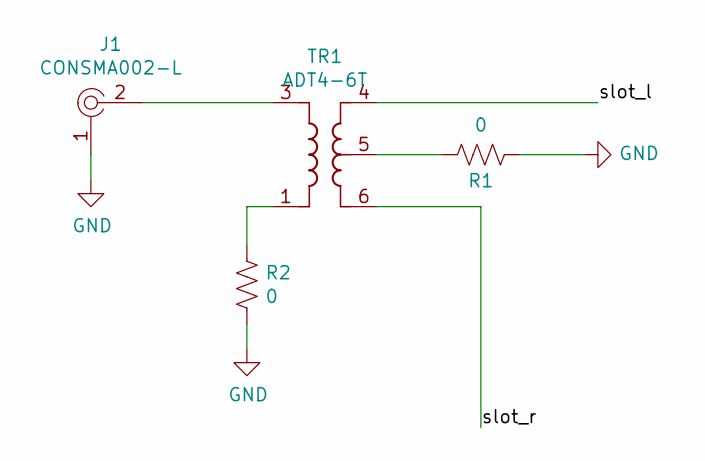
[picture p34: schematic xform-plug.sch]

Parts:
J1: CONSMA002-L; RF_SMA_RightAngle; Part Number CONSMA003-L
R1, R2: 0; 0603_R
TR1: ADT4-6T; Mini-Circuits_CD637_H5.23mm

Connections:
/slot_l: TR1.4
/slot_r: TR1.6
GND: J1.1, R1.1, R2.2
unnamed: J1.2, TR1.3
unnamed: R1.2, TR1.5
unnamed: R2.1, TR1.1

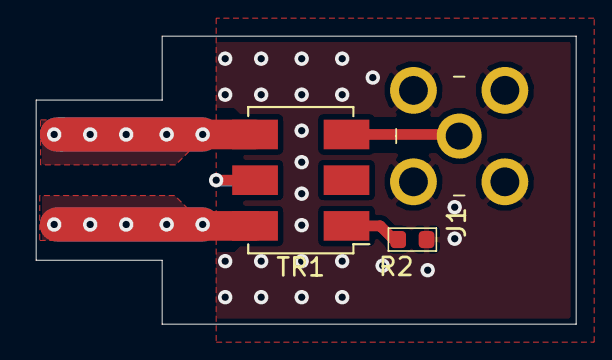
[picture p35: board xform-plug.kicad_pcb from above]

Board: 2 copper layers, 30.0 x 16.0 mm, 4 parts (1 on the bottom side), 4 nets.
