djsouthall/hpol-prototype/design/Feed Design/tri-slot-feedlines_revB/tri-slot-feedlines.kicad_pcb

## KiCad design design/Feed Design/tri-slot-feedlines_revB/tri-slot-feedlines.kicad_pcb (2020-10-09, an earlier design)

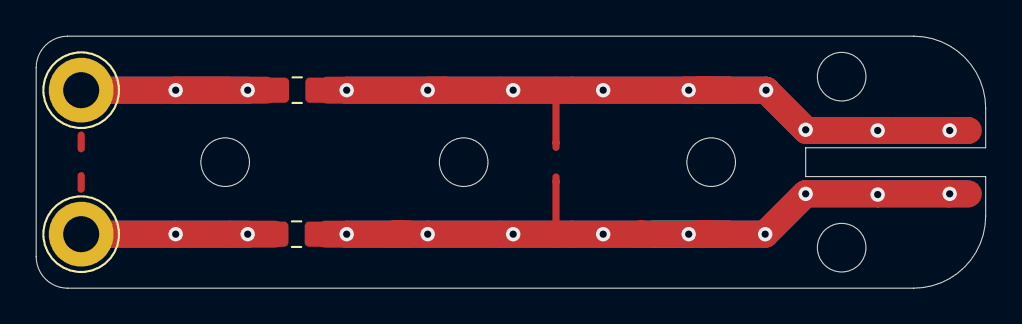
[picture p36: board design/Feed Design/tri-slot-feedlines_revB/tri-slot-feedlines.kicad_p… from above]

Board: 2 copper layers, 52.8 x 14.0 mm, 4 parts (0 on the bottom side), 2 nets.

Parts:
C1, C2: C; C_0805_2012Metric_Pad1.15x1.40mm_HandSolder
slot_l1: TestPoint; TestPoint_Loop_D3.80mm_Drill2.0mm
slot_r1: TestPoint; TestPoint_Loop_D3.80mm_Drill2.0mm

Connections:
unnamed: C1.2, slot_l1.1
unnamed: C2.2, slot_r1.1
