djsouthall/hpol-prototype/design/Feed Design/tri-slot-feedlines_revC/tri-slot-feedlines.kicad_pcb

## KiCad design design/Feed Design/tri-slot-feedlines_revC/tri-slot-feedlines.kicad_pcb (2020-10-09)

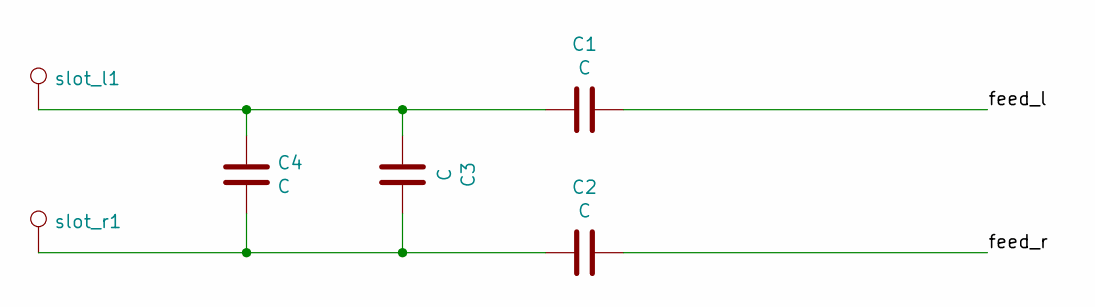
[picture p37: schematic tri-slot-feedlines.sch]

Parts:
C1, C2, C3, C4: C; C_0805_2012Metric_Pad1.15x1.40mm_HandSolder
slot_l1: TestPoint; TestPoint_Loop_D3.80mm_Drill2.0mm
slot_r1: TestPoint; TestPoint_Loop_D3.80mm_Drill2.0mm

Connections:
/feed_l: C1.1
/feed_r: C2.1
unnamed: C1.2, C3.2, C4.1, slot_l1.1
unnamed: C2.2, C3.1, C4.2, slot_r1.1

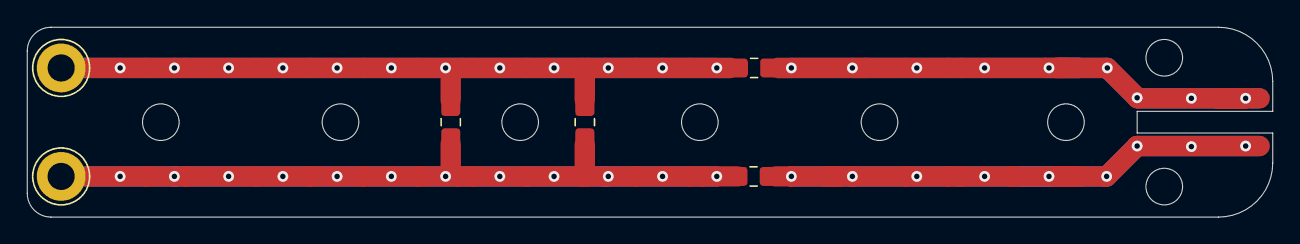
[picture p38: board design/Feed Design/tri-slot-feedlines_revC/tri-slot-feedlines.kicad_p… from above]

Board: 2 copper layers, 91.8 x 14.0 mm, 6 parts (0 on the bottom side), 2 nets.
