djsouthall/hpol-prototype/(commit log)

2020-03-02 Adding everything.
    [HPOL-2PF-30NH-SHUNT_STRAIGHT_LOGMAG.csv, HPOL-2PF-30NH-SHUNT_STRAIGHT_PHASE.csv, HPOL-2PF-30NH-SHUNT_STRAIGHT_SMITH.csv, HPOL_0OHM-NO-SHUNT_STRAIGHT_LOGMAG.csv, HPOL_0OHM-NO-SHUNT_STRAIGHT_PHASE.csv, HPOL_0OHM-NO-SHUNT_STRAIGHT_SMITH.csv, HPOL_0OHM_HOURGLASS2_LOGMAG.csv, HPOL_0OHM_HOURGLASS2_PHASE.csv]
2020-05-26 Added the files used for S21 measurements a long time ago.
    [HPOL_2.7PF-100NH-FEB27_ALICE-CAT2_LOGMAG.csv, HPOL_2.7PF-100NH-FEB27_ALICE-CAT2_PHASE.csv, HPOL_2.7PF-100NH-FEB27_BOB-DOG2_LOGMAG.csv, HPOL_2.7PF-100NH-FEB27_BOB-DOG2_PHASE.csv, HPOL_2.7PF-100NH_S11-ALICE_LOGMAG.csv, HPOL_2.7PF-100NH_S11-ALICE_PHASE.csv, HPOL_2.7PF-100NH_S11-NOSHIELD_LOGMAG.csv, HPOL_2.7PF-100NH_S11-NOSHIELD_PHASE.csv]
2020-08-20 Added some code to help predict the effects of adding inductors to the centerfeed. I would like to also use this tool to determine why what we measure is not what we predict.
    [HPOL_0OHM_HOURGLASS2_LOGMAG.csv, HPOL_0OHM_HOURGLASS2_PHASE.csv, HPOL_10PF_HOURGLASS2_LOGMAG.csv, HPOL_10PF_HOURGLASS2_PHASE.csv, HPOL_2PF_HOURGLASS2_LOGMAG.csv, HPOL_2PF_HOURGLASS2_PHASE.csv, HPOL_3.3PF_HOURGLASS2_LOGMAG.csv, HPOL_3.3PF_HOURGLASS2_PHASE.csv]
2020-08-21 Added another script. Investigating behaviour of adding L. Should not trust code at current stage.
    [hpol_emu_100nh_2p7pf_v1_LOGMAG.csv, hpol_emu_100nh_2p7pf_v1_PHASE.csv]
2020-09-24 Updated the shunt investigation script from recent work. Additionally the SmithMatcher class has been given much of the functionality of the daughter HpolTriWing class and should be used.
    [hpol_bee_22nh_2p7pf_LOGMAG.csv, hpol_bee_22nh_2p7pf_PHASE.csv, hpol_chuckape_27nh_2p7pf_LOGMAG.csv, hpol_chuckape_27nh_2p7pf_PHASE.csv, hpol_davebee_27nh_2p7pf_LOGMAG.csv, hpol_davebee_27nh_2p7pf_PHASE.csv, hpol_ernieemu_100nh_2p7pf_LOGMAG.csv, hpol_ernieemu_100nh_2p7pf_PHASE.csv]
2020-09-28 Added 22nh Al measurements.
    [hpol_ernieemu_22nh_2p7pF_LOGMAG.csv, hpol_ernieemu_22nh_2p7pF_PHASE.csv]
2020-09-30 Made some plots for the presentation and uploaded more data.
    [hpol_fionafox_47nh_2p7pf_LOGMAG.csv, hpol_fionafox_47nh_2p7pf_PHASE.csv]
2020-10-01 Added more data.
    [hpol_fionafox_100nh_2p7pf_LOGMAG.csv, hpol_fionafox_100nh_2p7pf_PHASE.csv]
2020-10-09 Added design files to this repository.
    Added both the inventor models and the current kicad files for the HPol prototype. I have been working on these for a while but they were not on git.
    [32K701-200E3.iam, 90001A403_TYPE 18-8 STAINLESS STEEL HEX NUT.STEP, 90001A403_TYPE 18-8 STAINLESS STEEL HEX NUT.ipt, 90001A605_TYPE 18-8 STAINLESS STEEL HEX NUT.0001.ipt, 90001A605_TYPE 18-8 STAINLESS STEEL HEX NUT.STEP, 90001A605_TYPE 18-8 STAINLESS STEEL HEX NUT.ipt, 90910A440_BUTTON HEAD TORX SCREWS.STEP, 90910A440_BUTTON HEAD TORX SCREWS.ipt]
2020-10-09 Create digikey-mockup-A114140-ND_8in.stp
    Added the current mockup for a bent A114140-ND part to fit within the 8in antenna.
    [digikey-mockup-A114140-ND_8in.stp]
2020-10-09 Updated models of insert and can for 2 support holes and added tolerance.
    [assembled-antenna.0034.iam, assembled-antenna.0036.iam, assembled-antenna.iam, assembled-feed.0026.iam, assembled-feed.0028.iam, assembled-feed.iam, can.0037.ipt, can.0039.ipt]
2020-10-09 Added Cu traces to feedline model for 8in.
    [antenna_comparison.0002.iam, antenna_comparison.iam, assembled-antenna.0036.iam, assembled-antenna.0037.iam, assembled-antenna.iam, assembled-feed.0028.iam, assembled-feed.0029.iam, assembled-feed.iam]
2020-10-16 Added hub parts from Eric
    [assembled-feed.0029.iam, assembled-feed.0030.iam, assembled-feed.iam, assembled-feed.stp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]
2020-10-19 Pushing Cam files
    [32K701-200E3.iam, 90001A403_TYPE 18-8 STAINLESS STEEL HEX NUT.STEP, 90001A403_TYPE 18-8 STAINLESS STEEL HEX NUT.ipt, 90001A605_TYPE 18-8 STAINLESS STEEL HEX NUT.0001.ipt, 90001A605_TYPE 18-8 STAINLESS STEEL HEX NUT.STEP, 90001A605_TYPE 18-8 STAINLESS STEEL HEX NUT.ipt, 90910A440_BUTTON HEAD TORX SCREWS.STEP, 90910A440_BUTTON HEAD TORX SCREWS.ipt]
2020-10-19 Laying groundwork for quadslot build.
    [32K701-200E3.iam, 90001A403_TYPE 18-8 STAINLESS STEEL HEX NUT.STEP, 90001A403_TYPE 18-8 STAINLESS STEEL HEX NUT.ipt, 90001A605_TYPE 18-8 STAINLESS STEEL HEX NUT.0001.ipt, 90001A605_TYPE 18-8 STAINLESS STEEL HEX NUT.STEP, 90001A605_TYPE 18-8 STAINLESS STEEL HEX NUT.ipt, 90910A440_BUTTON HEAD TORX SCREWS.STEP, 90910A440_BUTTON HEAD TORX SCREWS.ipt]
2020-10-19 Quad slot parts underway
    The quadslot open and closed versions are moving long. Closed is complete likely to an orderable state, the open needs more work to account for holes and structural supports.
    [2933-6001.STEP, assembled-closed-antenna.0038.iam, assembled-closed-antenna.0039.iam, assembled-closed-antenna.iam, assembled-feed.0033.iam, assembled-feed.0034.iam, assembled-feed.iam, assembled-open-antenna.0040.iam]
2020-10-19 Fixing some things with the trislots. Adding open trislots.
    Minor changes to fix constraints found when making quadslot.
    [assembled-closed-antenna.0038.iam, assembled-closed-antenna.0039.iam, assembled-closed-antenna.iam, assembled-feed_feedline_8in.0007.iam, assembled-feed_feedline_8in.0008.iam, assembled-feed_feedline_8in.iam, assembled-open-antenna.0040.iam, assembled-open-antenna.0041.iam]
2020-10-20 Good progress on quad hub design. Just need to check for hardware conflicts.
    [assembled-closed-antenna.0039.iam, assembled-closed-antenna.0040.iam, assembled-closed-antenna.iam, assembled-feed.0034.iam, assembled-feed.0037.iam, assembled-feed.iam, quad-slot-hub-traces.step, quad-slot-hub.kicad_pcb]
2020-10-20 Added some work towards testing the presence of a transformer. It is all very incomplete.
    [600mm 8in OD Closed Al Impedance.csv, 600mm 8in OD Closed Al S11.csv]
2020-10-27 Updating trislots and other parts.
    [92196A077_18-8 STAINLESS STEEL SOCKET HEAD SCR.ipt, 92196A077_18-8 STAINLESS STEEL SOCKET HEAD SCREW.STEP, assembled-closed-antenna.0040.iam, assembled-closed-antenna.0041.iam, assembled-closed-antenna.iam, assembled-feed.0037.iam, assembled-feed.0040.iam, assembled-feed.iam]
2020-11-03 Pushing updated data and model stp files.
    [can_closed.stp, can_open.stp, quad-assembled-feed-v1.stp, quadslot_0Ohm_taped_LOGMAG.csv, quadslot_0Ohm_taped_PHASE.csv]
2020-11-04 Updated model
    [assembled-feed.0040.iam, assembled-feed.0041.iam, assembled-feed.iam, quad-assembled-feed-v2.stp, quad-slot-hub-traces.step, quad-slot-hub_inaccurate.kicad_pcb]
2020-11-07 data
    data
    [hpol_gordoboar_1x47nH_2x6p8pF_LOGMAG.csv, hpol_gordoboar_1x47nH_2x6p8pF_PHASE.csv, hpol_gordoboar_1x47nH_2x6p8pF_cbl_LOGMAG.csv, hpol_gordoboar_1x47nH_2x6p8pF_cbl_PHASE.csv, hpol_gordoboar_NOSHUNT_0ohm_LOGMAG.csv, hpol_gordoboar_NOSHUNT_0ohm_PHASE.csv]
2020-11-12 Adding data
    [hpol_gordoboar_1x47nH_2x6p8pF_LOGMAG.csv, hpol_gordoboar_1x47nH_2x6p8pF_PHASE.csv, hpol_gordoboar_1x47nH_2x6p8pF_cbl_LOGMAG.csv, hpol_gordoboar_1x47nH_2x6p8pF_cbl_PHASE.csv, hpol_gordoboar_1x47nh_2x3p3pf_LOGMAG.csv, hpol_gordoboar_1x47nh_2x3p3pf_PHASE.csv, hpol_gordoboar_NOSHUNT_0ohm_LOGMAG.csv, hpol_gordoboar_NOSHUNT_0ohm_PHASE.csv]
2020-11-13 Cad and drawing files updated.
    [can_closed.0047.ipt, can_closed.0049.ipt, can_closed.ipt, insert_8in.0017.ipt, insert_8in.0018.ipt, insert_8in.ipt, quadslot_8in_can_closed_v1.stp, quadslot_8in_can_drawing_v1.0003.dwg]
2020-11-13 Further update on drawings
    [quadslot_8in_can_drawing_v1.0003.dwg, quadslot_8in_can_drawing_v1.0004.dwg, quadslot_8in_can_drawing_v1.dwg, quadslot__8in_insert_drawing_v1.0007.dwg, quadslot__8in_insert_drawing_v1.0008.dwg, quadslot__8in_insert_drawing_v1.dwg]
2020-11-19 A lot of model changes in prep for RNO-G report. Made end caps.
    [End Cap.0022.ipt, End Cap.ipt, Short Support.ipt, assembled-closed-antenna.0038.iam, assembled-closed-antenna.0039.iam, assembled-closed-antenna.0040.iam, assembled-closed-antenna.0041.iam, assembled-closed-antenna.0048.iam]
2020-11-19 Slight changes to design files. Included the front end box.
    [End Cap.0022.ipt, End Cap.0034.ipt, End Cap.ipt, assembled-closed-antenna.0048.iam, assembled-closed-antenna.0054.iam, assembled-closed-antenna.iam, front_end_box.STEP]
2020-11-19 Added some wiggle room to inserts
    [End Cap.0034.ipt, End Cap.0039.ipt, End Cap.ipt, assembled-closed-antenna.0054.iam, assembled-closed-antenna.0058.iam, assembled-closed-antenna.iam, assembled-feed.0042.iam, assembled-feed.0044.iam]
2020-12-08 Updates for making the end cap drawing.
    Updates for making the end cap drawing.
    [99362A200_TAPPING INSERTS FOR PLASTICS.STEP, 99362A200_TAPPING INSERTS FOR PLASTICS.ipt, End Cap.0039.ipt, End Cap.0061.ipt, End Cap.ipt, assembled-closed-antenna.0058.iam, assembled-closed-antenna.0063.iam, assembled-closed-antenna.iam]
